SciDROM-scnm/LoRa_AQ/README.md

# LoRa_AQ
LoRa Air Quality station

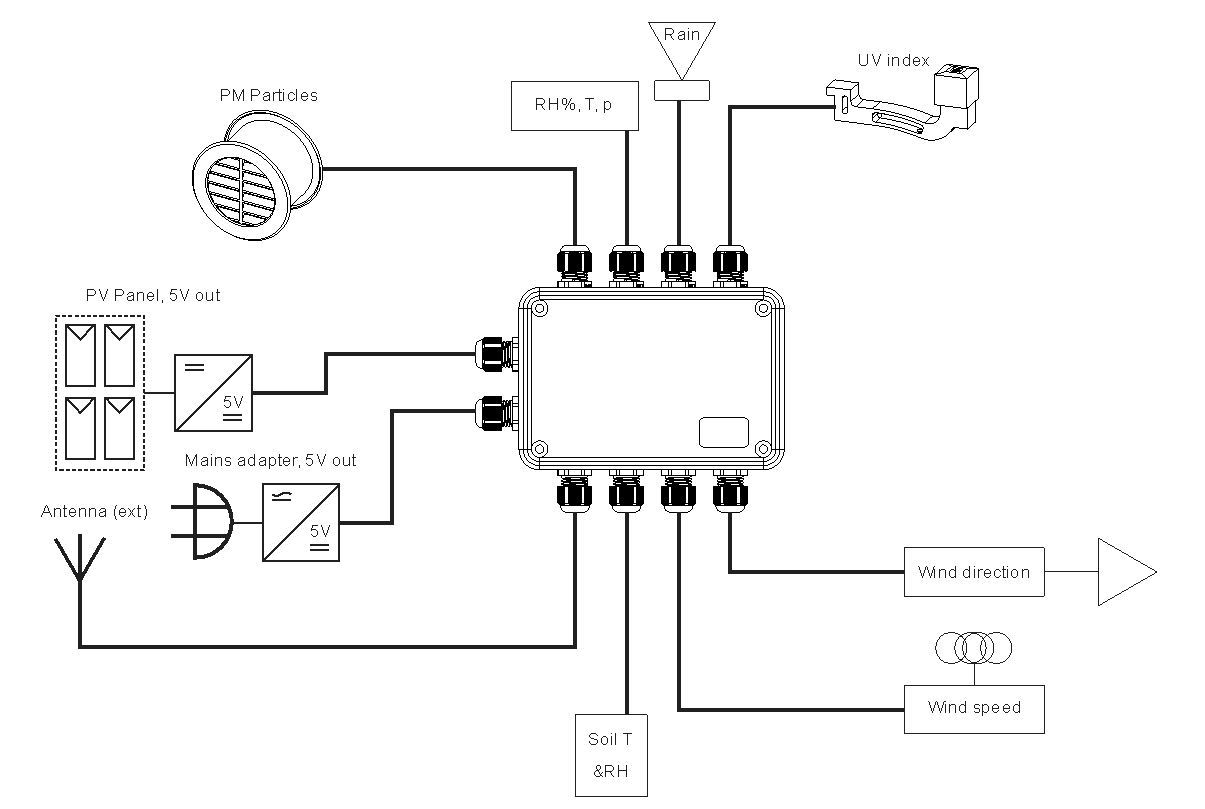
[picture p1: hw/block.jpg]
Block diagram
