SciDROM-scnm/LoRa_AQ/hw/photo/zlotano.jpg

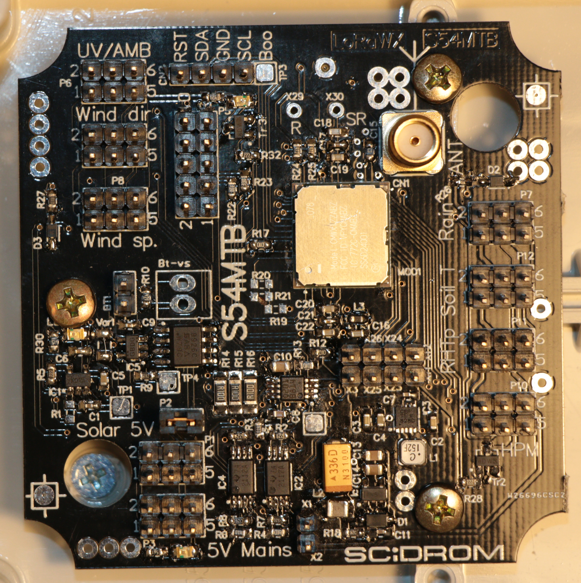
hw/photo/zlotano.jpg
