SciDROM-scnm/LoRa_AQ/hw/instructions/readme.md

## Instructions for assembling hardware

## Navodila za sestavljanje
