SciDROM-scnm/LoRa_AQ/hw/instructions/SLO/scidrom-PM - Priprava senzorja osvetlitve.pdf

LORA SENZORSKA POSTAJA ZA
SPREMLJANJE OKOLJA

## Šolski center Novo mesto SEŠTG 2018

## Mentor: Marko Pavlin

# PRIPRAVA

# SENZORJA OSVETLITVE

1

VSEBINA

2

SENZOR OSVETLITVE

Senzor osvetlitve je namenjen merjenju dnevne svetlobe in jakosti UV sevanja v spektru UVA in UVB.

Izgled sestavljenega senzorja:

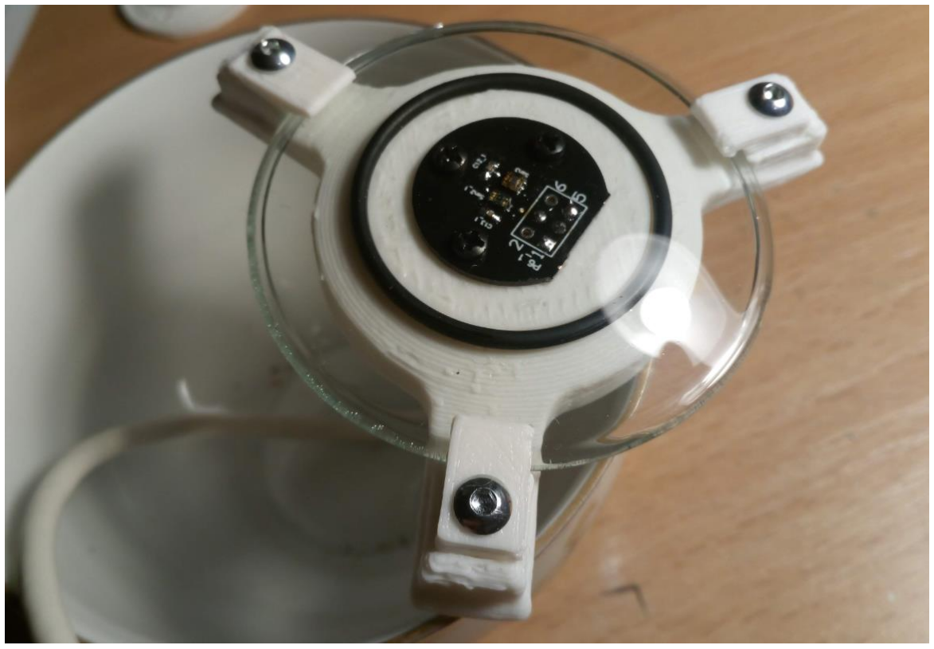
[picture p38: figure]

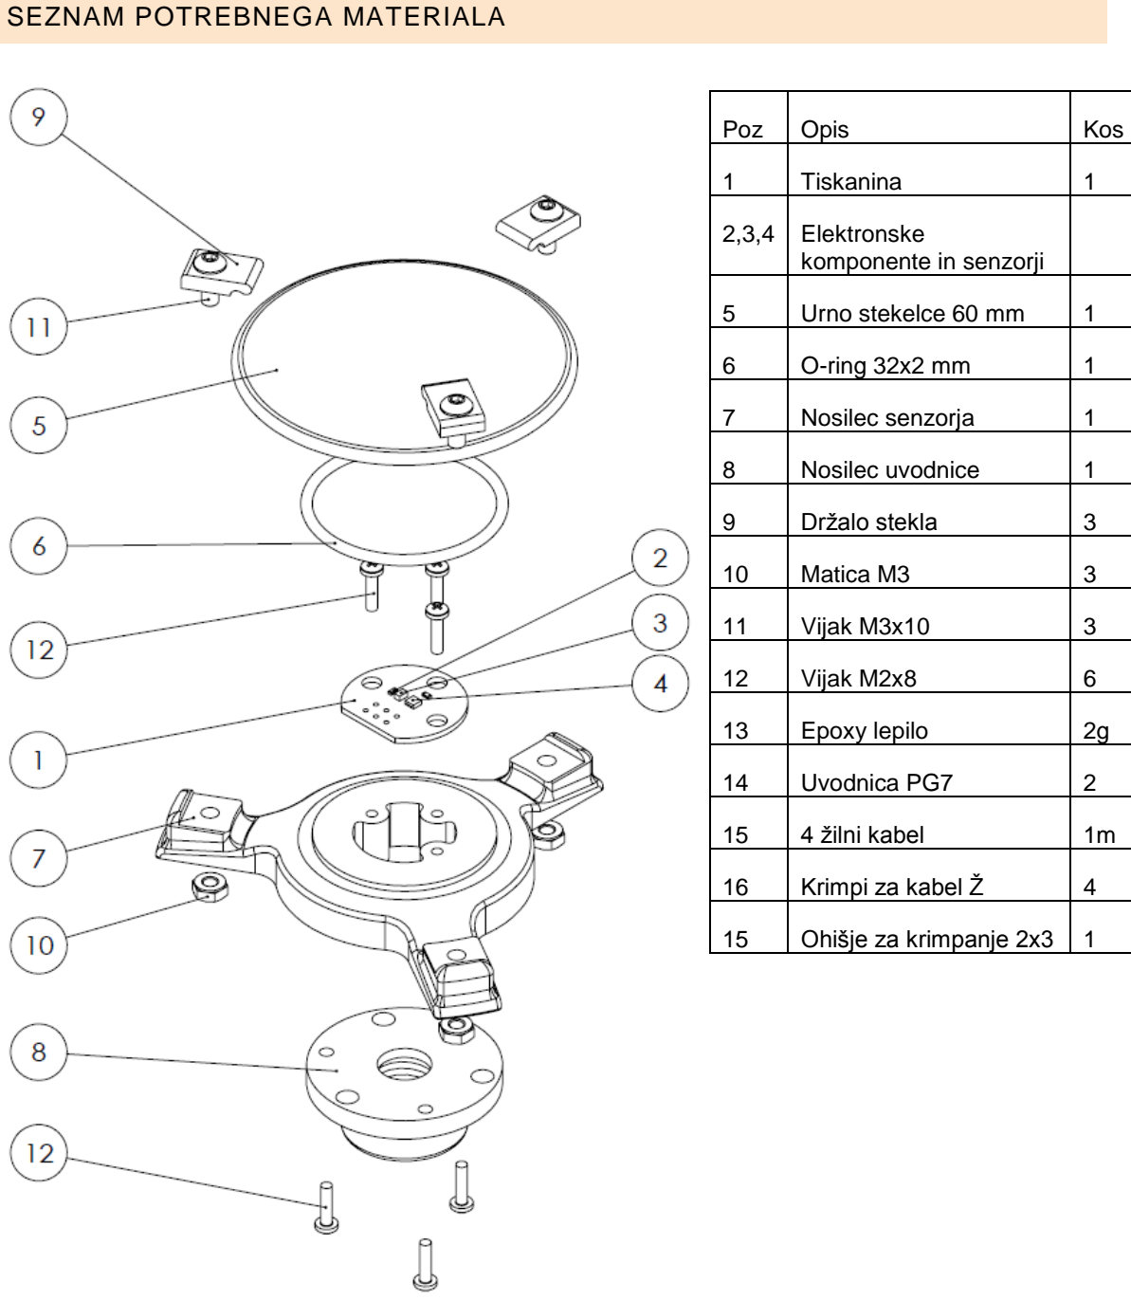
[picture p39: figure]
SEZNAM POTREBNEGA MATERIALA; Poz; Opis; Kos; Tiskanina; Elektronske komponente in senzorji; Urno stekelce 60 mm; O-ring 32x2 mm; Nosilec senzorja; Nosilec uvodnice; Držalo stekla; Matica M3; Vijak M3x10; Vijak M2x8; Epoxy lepilo; Uvodnica PG7; 4 žilni kabel; Krimpi za kabel Ž; Ohišje za krimpanje 2x3

3

4

POTREBNO ORODJE

Spajkalnik, ščipalke, klešče za snemanje izolacije, klešče za krimpanje kontaktov, šivalni stroj, škarje, pribor za mešanje epoxy lepila.

PRIPRAVA KABLA

Kablu na obeh koncih odstranimo oklop v razdalji pribl 25-30 mm in pripravimo notranje žile za spajkanje oz. krimpanje. Na strani senzorja prispajkamo žile kabla na tiskanino po naslednjem razporedu:

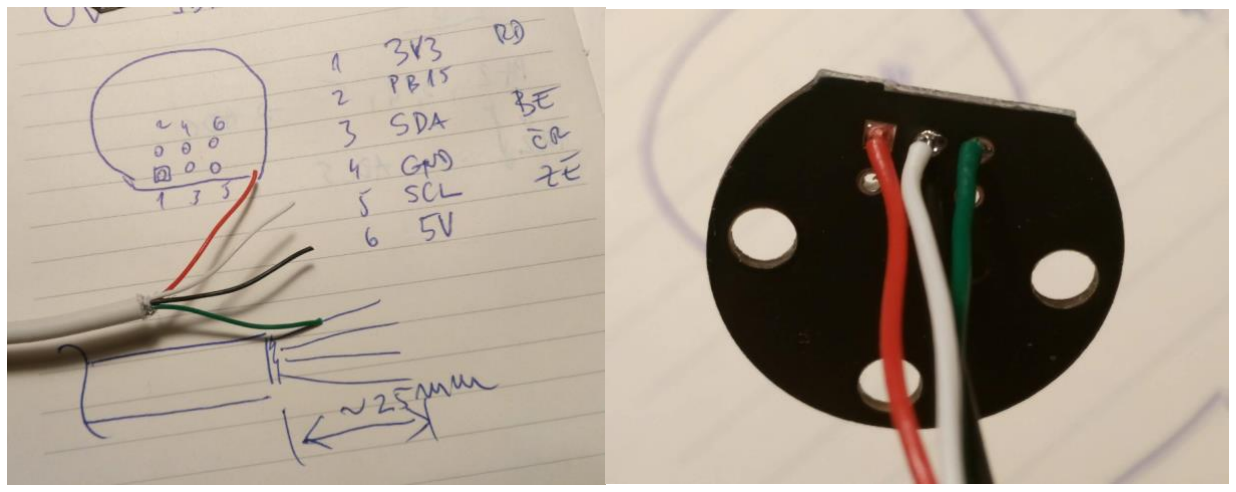
[picture p40: figure]

Shema konektorja:

Razpored:

Št. pina | Signal | Barva
1 | Napajanje 3,3V | Rdeča
2 | IRQ signal | Ni priključeno
3 | SDA | Bela
4 | GND | Črna
5 | SCL | Zelena
6 | +5V | Ni priključeno

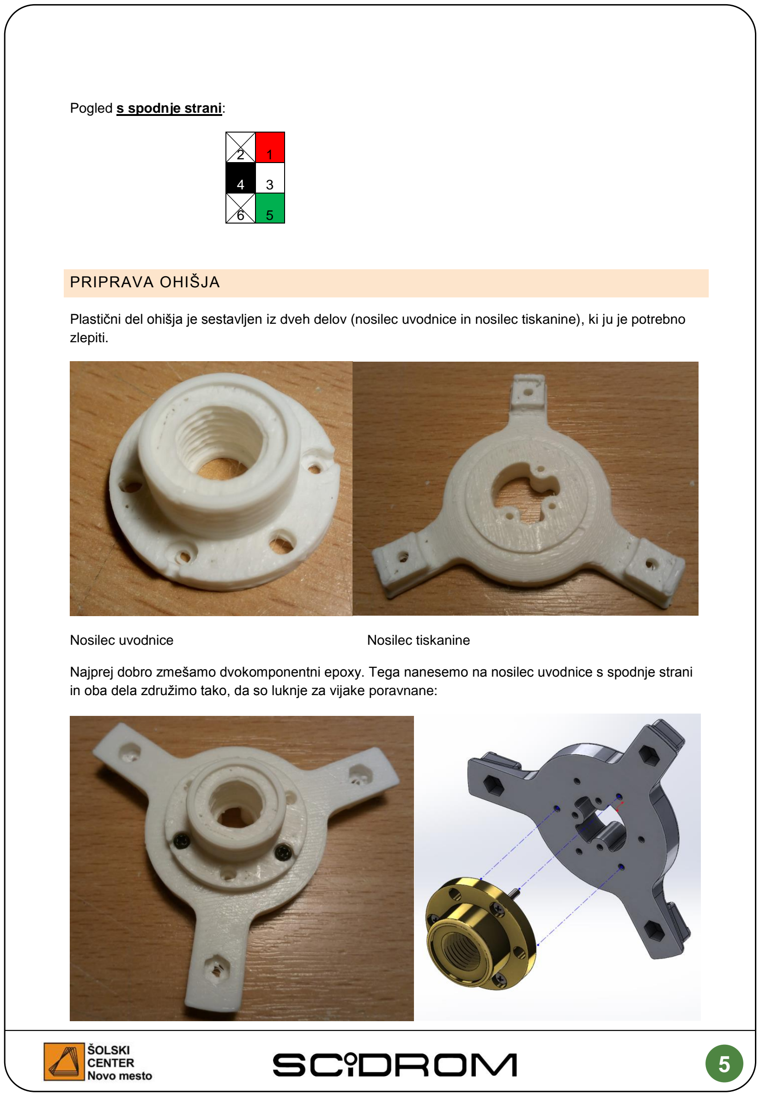
[picture p41: page 6]

5

Pogled s spodnje strani:

2 | 1
4 | 3
6 | 5

PRIPRAVA OHIŠJA

Plastični del ohišja je sestavljen iz dveh delov (nosilec uvodnice in nosilec tiskanine), ki ju je potrebno zlepiti.

Nosilec uvodnice | Nosilec tiskanine

Najprej dobro zmešamo dvokomponentni epoxy. Tega nanesemo na nosilec uvodnice s spodnje strani in oba dela združimo tako, da so luknje za vijake poravnane:

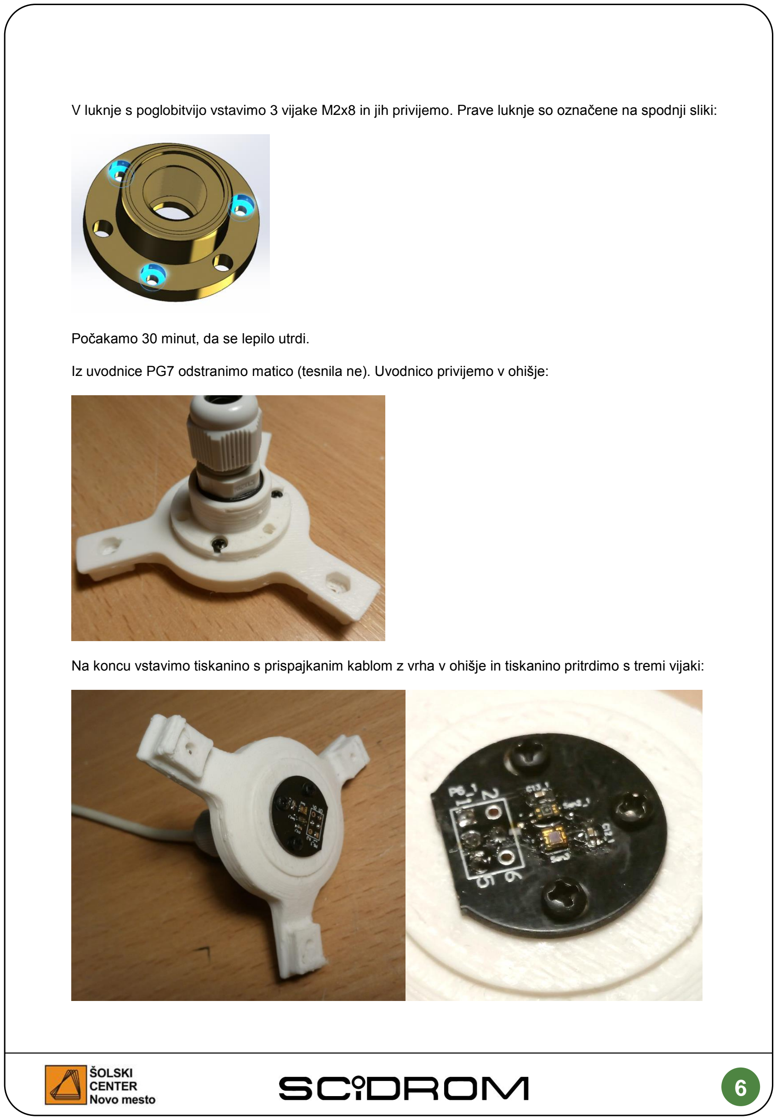
[picture p42: page 7]

6

V luknje s poglobitvijo vstavimo 3 vijake M2x8 in jih privijemo. Prave luknje so označene na spodnji sliki:

Počakamo 30 minut, da se lepilo utrdi.

Iz uvodnice PG7 odstranimo matico (tesnila ne). Uvodnico privijemo v ohišje:

Na koncu vstavimo tiskanino s prispajkanim kablom z vrha v ohišje in tiskanino pritrdimo s tremi vijaki:

7

Na krake ohišja s spodnje strani vstavimo tri matice M3:

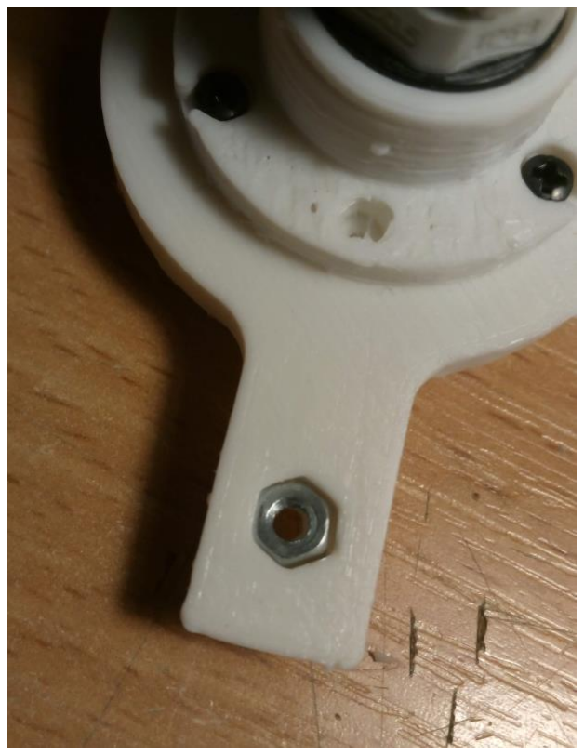
[picture p43: figure]

Na zgornjo stran ohišja postavimo O-ring:

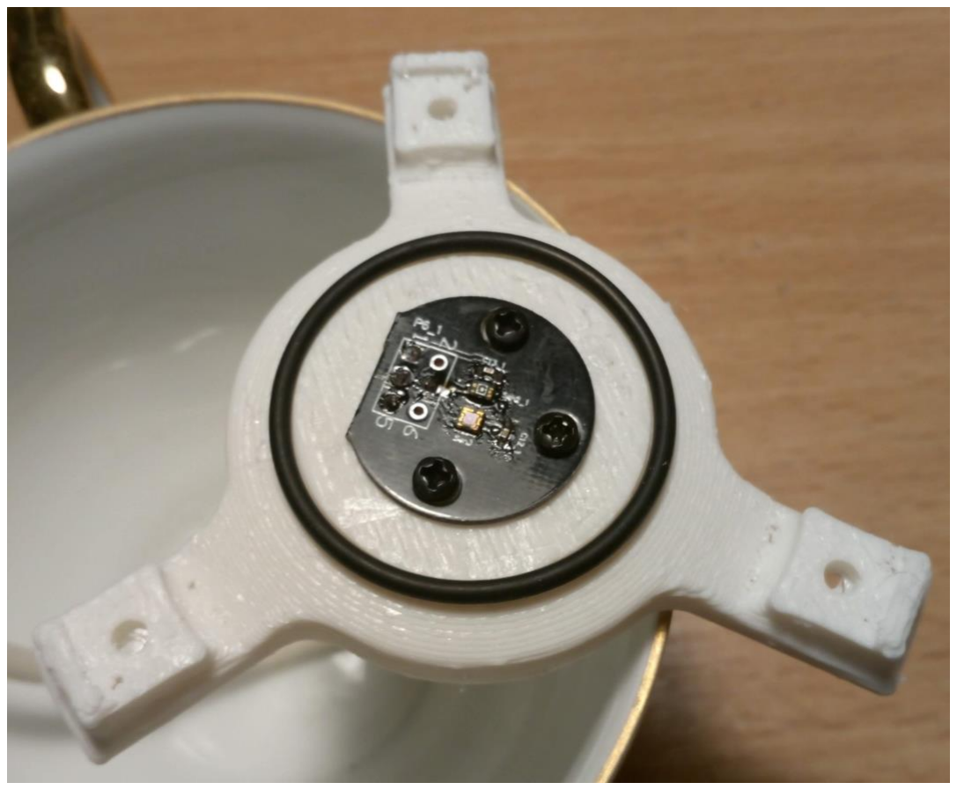
[picture p44: figure]

8

Očistimo urno stekelce, predvsem z notranje strani in ga postavimo na tesnilo:

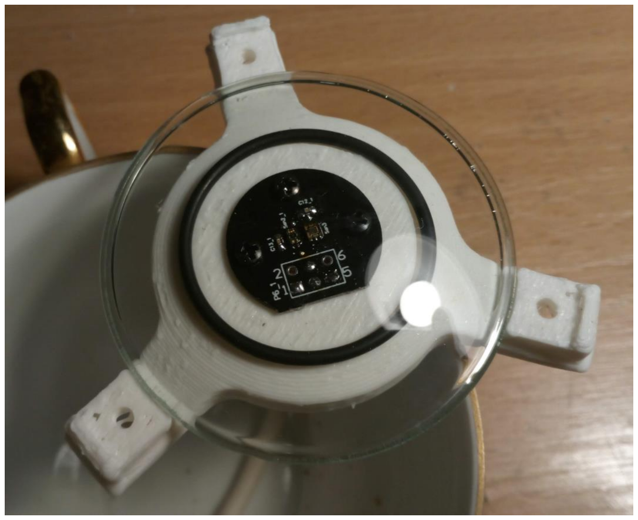
[picture p45: figure]

Steklo pritrdimo s tremi nosilci in privijemo s tremi vijaki M3x10:

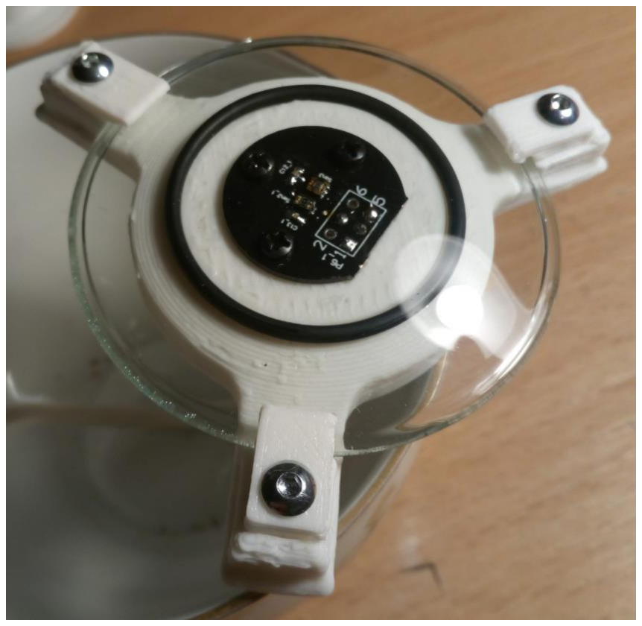
[picture p46: figure]
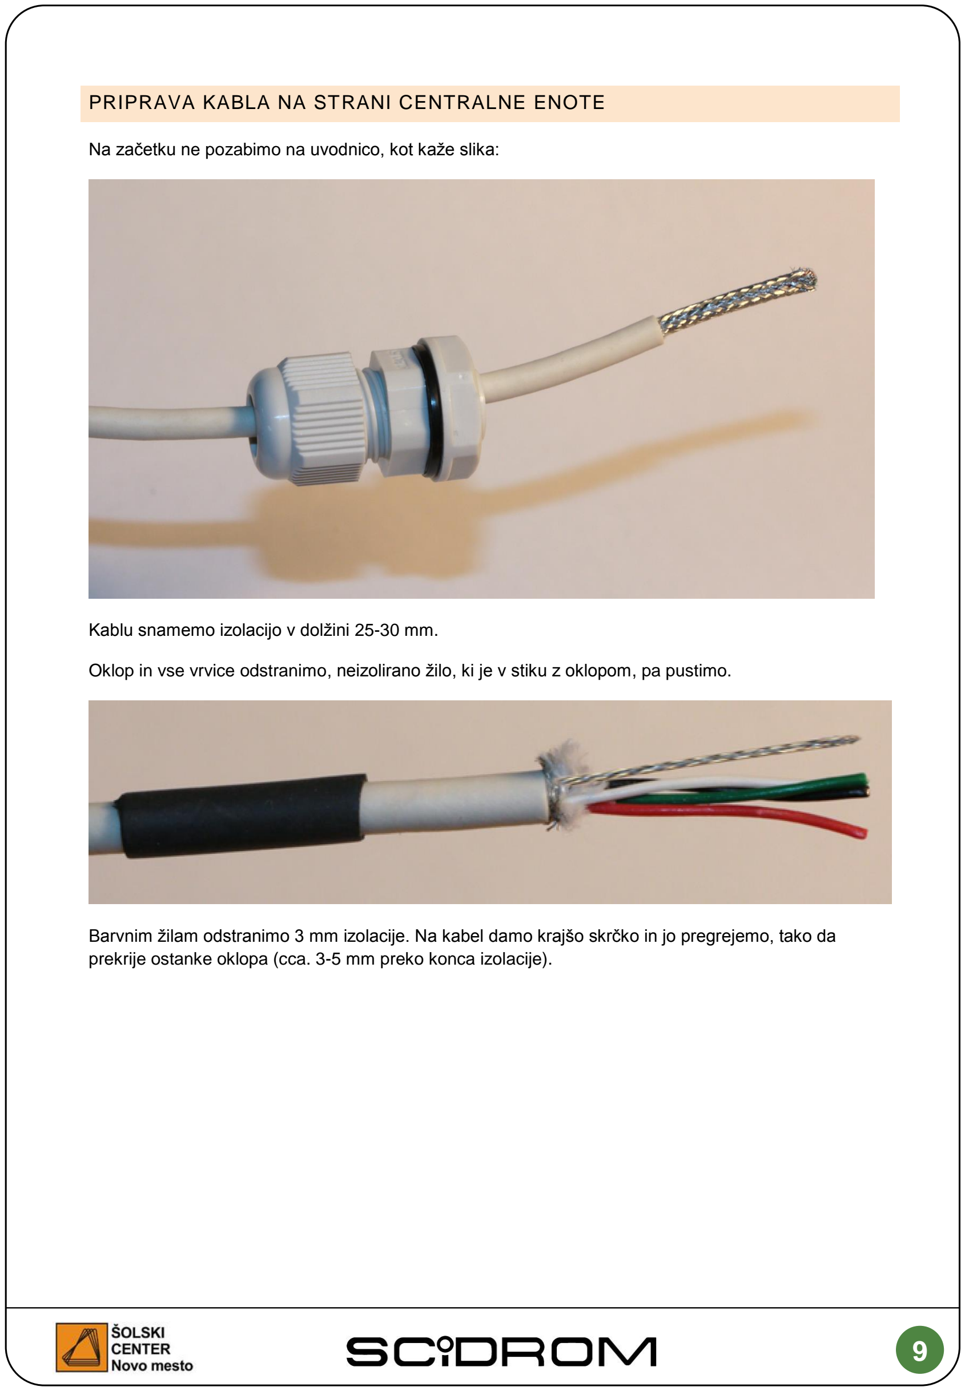
[picture p47: page 10]

9

PRIPRAVA KABLA NA STRANI CENTRALNE ENOTE

Na začetku ne pozabimo na uvodnico, kot kaže slika:

Kablu snamemo izolacijo v dolžini 25-30 mm.

Oklop in vse vrvice odstranimo, neizolirano žilo, ki je v stiku z oklopom, pa pustimo.

Barvnim žilam odstranimo 3 mm izolacije. Na kabel damo krajšo skrčko in jo pregrejemo, tako da prekrije ostanke oklopa (cca. 3-5 mm preko konca izolacije).

10

Neizolirano žico povijemo okrog črne.

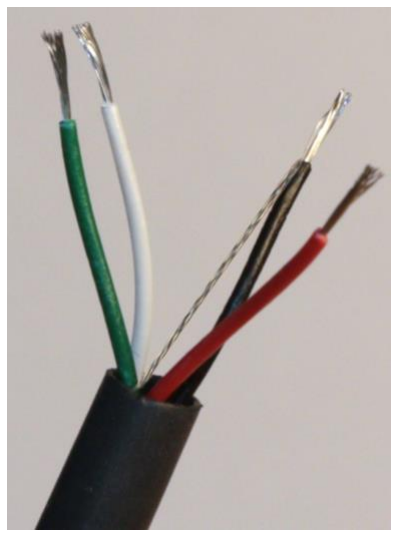
[picture p48: figure]

Pripravimo 4 JST kontakte za krimpanje.

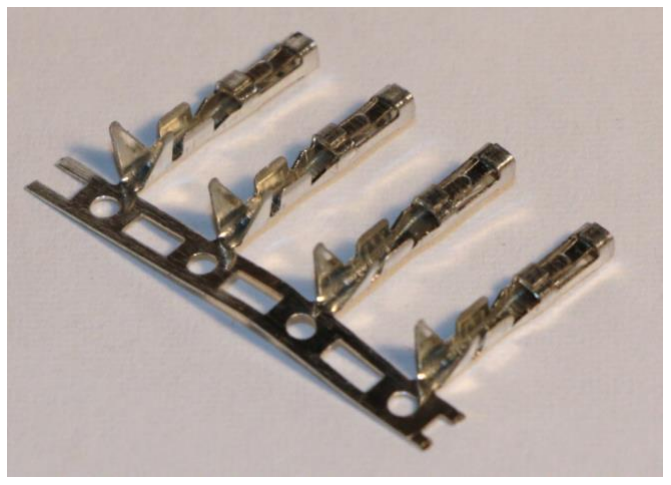
[picture p49: figure]

Za krimpanje potrebujemo klešče PA09 ali podobne.

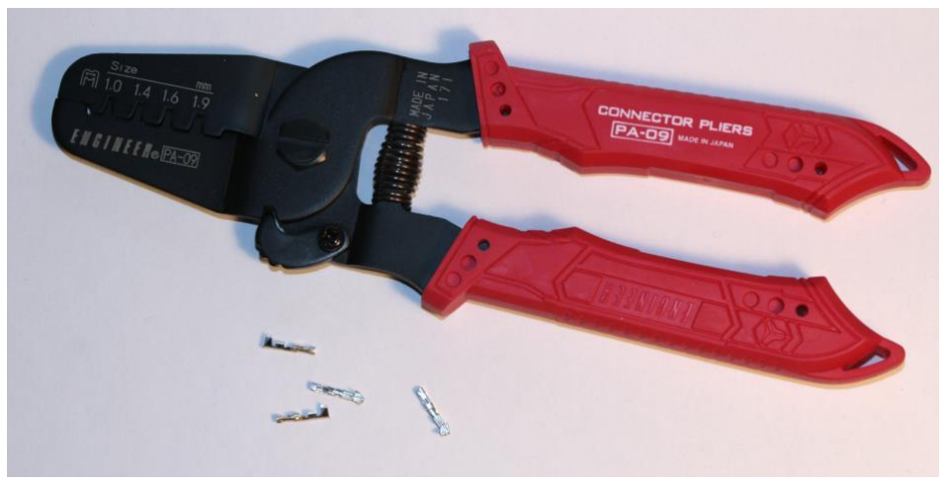
[picture p50: figure]

S takimi kleščami se krimpa v dveh potezah. Najprej del, ki objame neizoliran konec žice, sledi še drugi del, ki objame izolacijo. To ponovimo na vseh štirih žicah. Na spodnji fotografiji je na črni žici končano krimpanje, na beli pa le prvi korak:

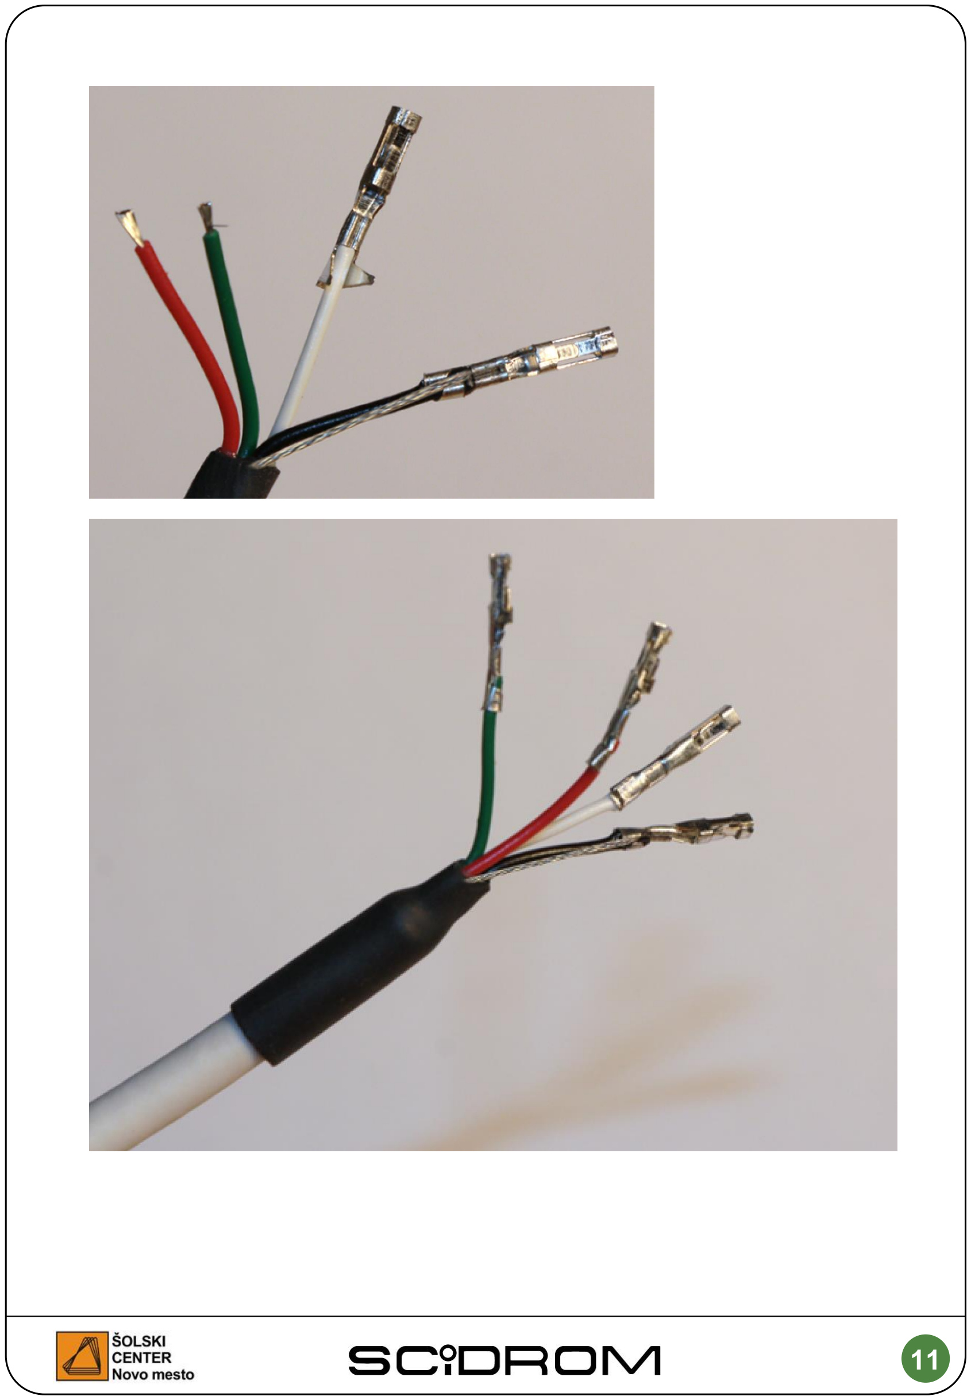
[picture p51: page 12]

11

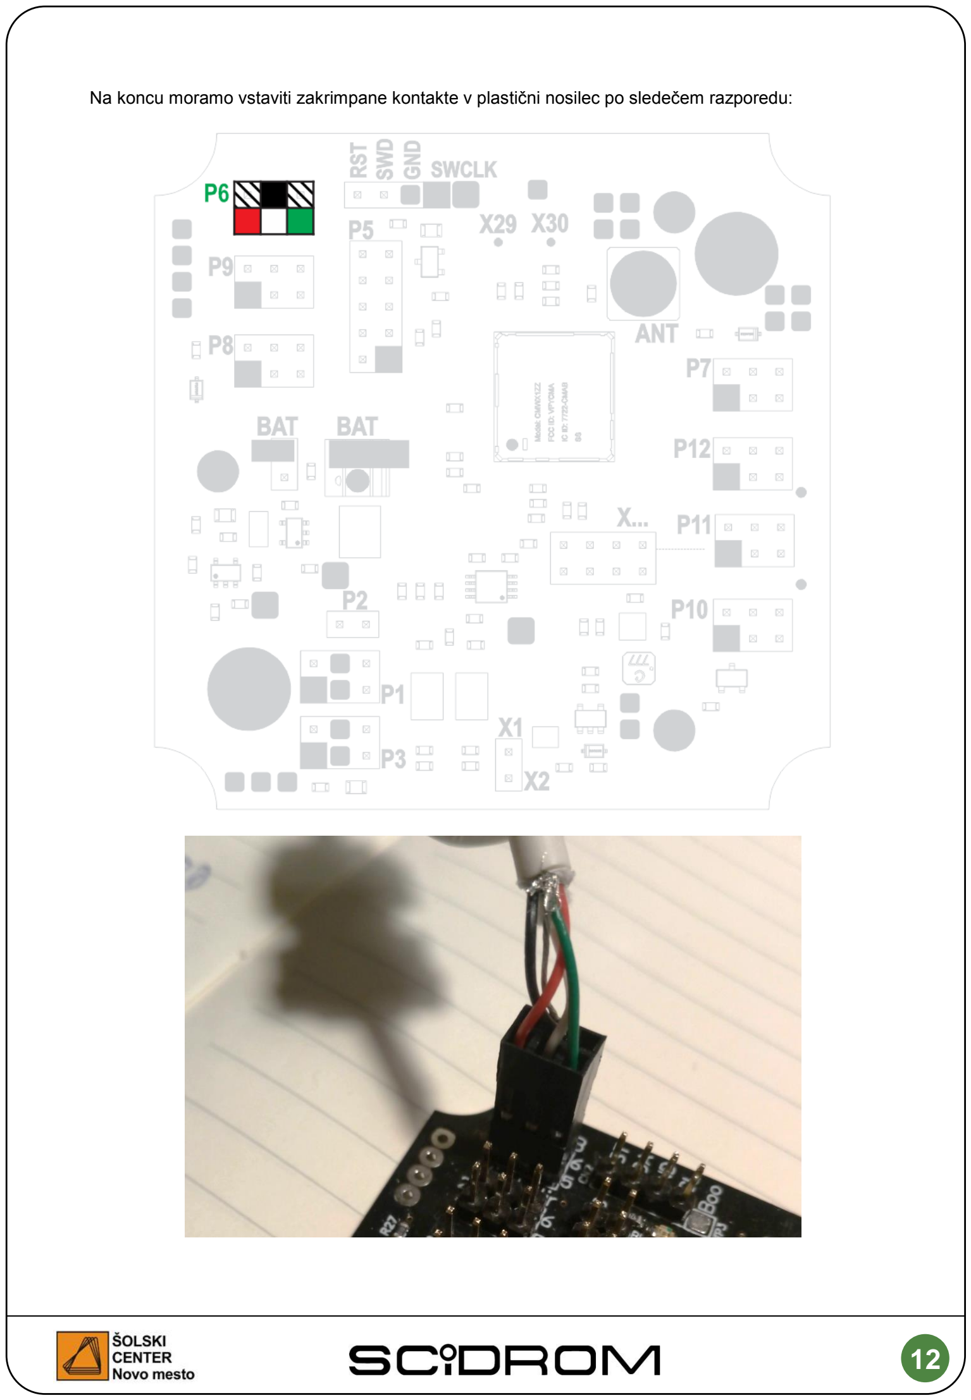
[picture p52: page 13]

12

Na koncu moramo vstaviti zakrimpane kontakte v plastični nosilec po sledečem razporedu:

13

Zapiski
