SciDROM-scnm/LoRa_AQ/hw/instructions/SLO/scidrom-PM - Priprava zascitnega ohisja za senzorje.pdf

LORA SENZORSKA POSTAJA ZA
SPREMLJANJE OKOLJA

## Šolski center Novo mesto SEŠTG 2018

## Mentor: Marko Pavlin

# PRIPRAVA ZAŠČITE ZA OKOLJSKE SENZORJE

1

VSEBINA

2

ZAŠČITNI ZASTOR ZA SENZORJE

Plastični zastor služi zaščiti senzorjev za vlago, temperaturo in tlak pred vplivom direktnih sončnih žarkov. Senzorji se nahajajo v notranjsti zastora, ki daje senco, obenem pa preko rež na obodu kroži zrak in omogoča zaznavanje stanja atmosfere. Celoten sestav je narejen iz plastičnih podstavkov, ki se uporabljajo za cvetlične lončke.

PRIPRAVA CVETLIČNIH PODSTAVKOV

Cvetlične postavke premera 120mm je potrebno izrezati po načrtu:

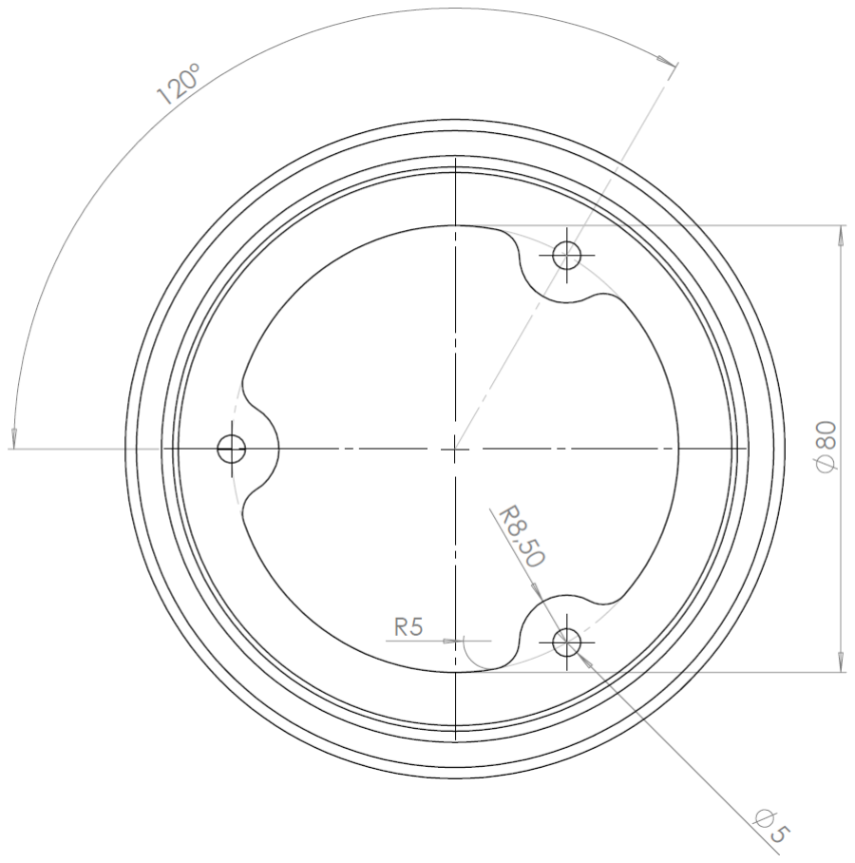
[picture p61: figure]
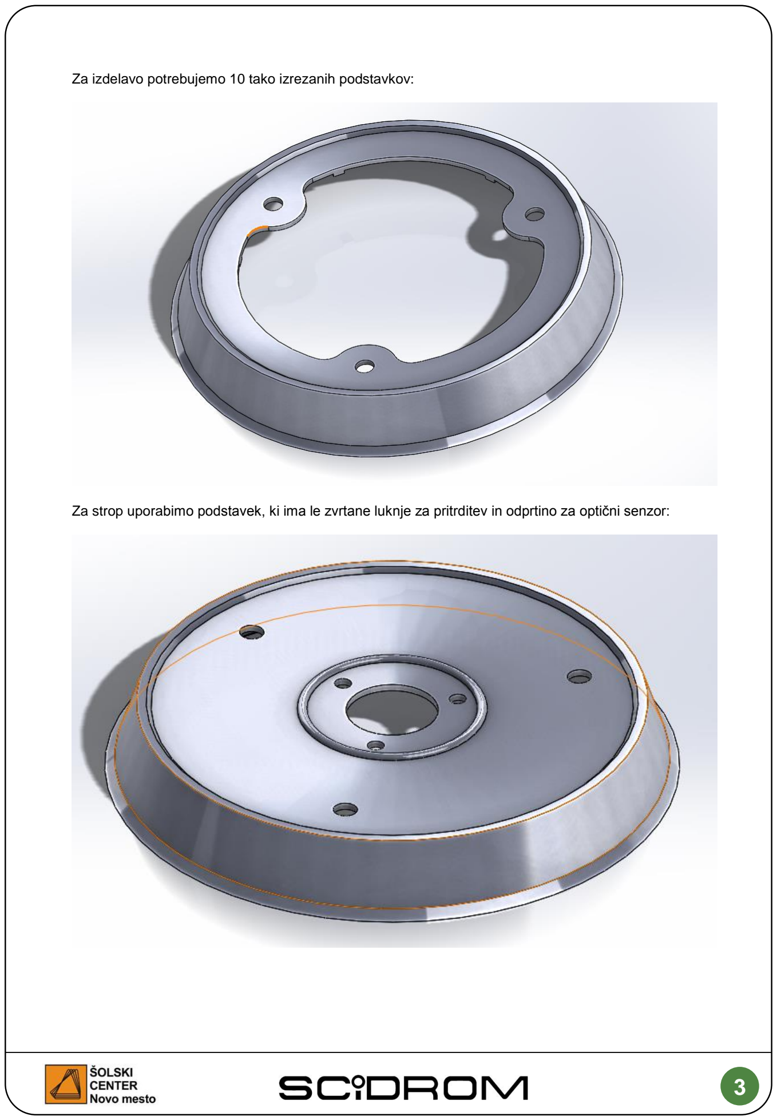
[picture p62: page 4]

3

Za izdelavo potrebujemo 10 tako izrezanih podstavkov:

Za strop uporabimo podstavek, ki ima le zvrtane luknje za pritrditev in odprtino za optični senzor:

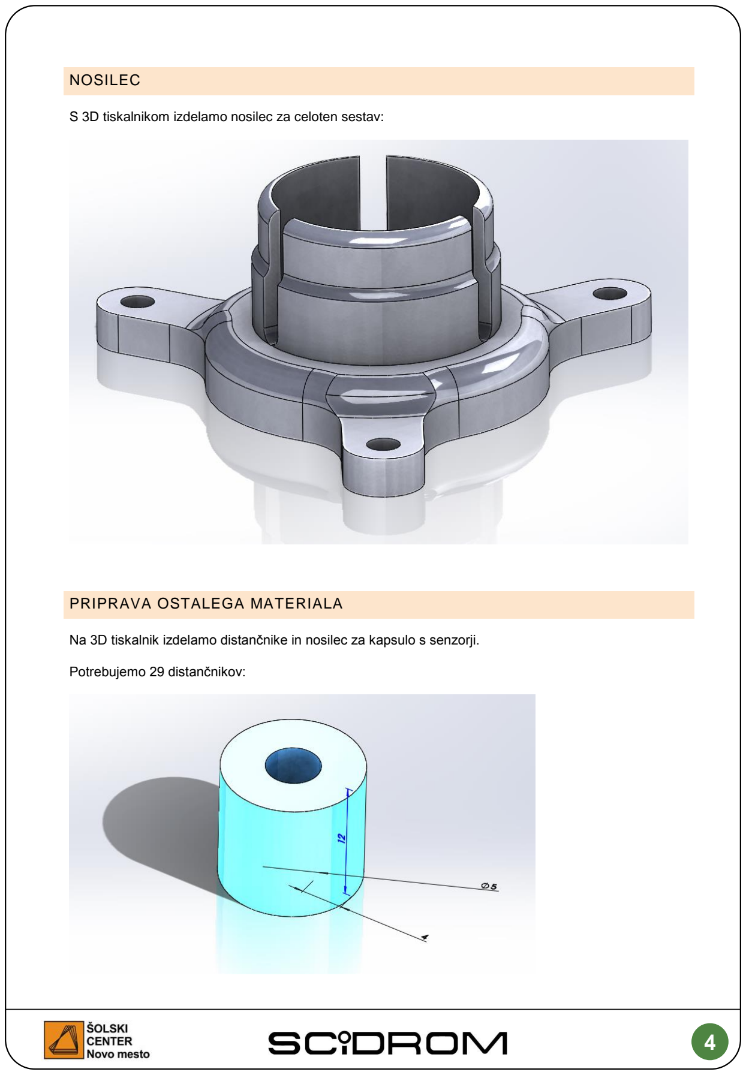
[picture p63: page 5]

4

NOSILEC

S 3D tiskalnikom izdelamo nosilec za celoten sestav:

PRIPRAVA OSTALEGA MATERIALA

Na 3D tiskalnik izdelamo distančnike in nosilec za kapsulo s senzorji.

Potrebujemo 29 distančnikov:

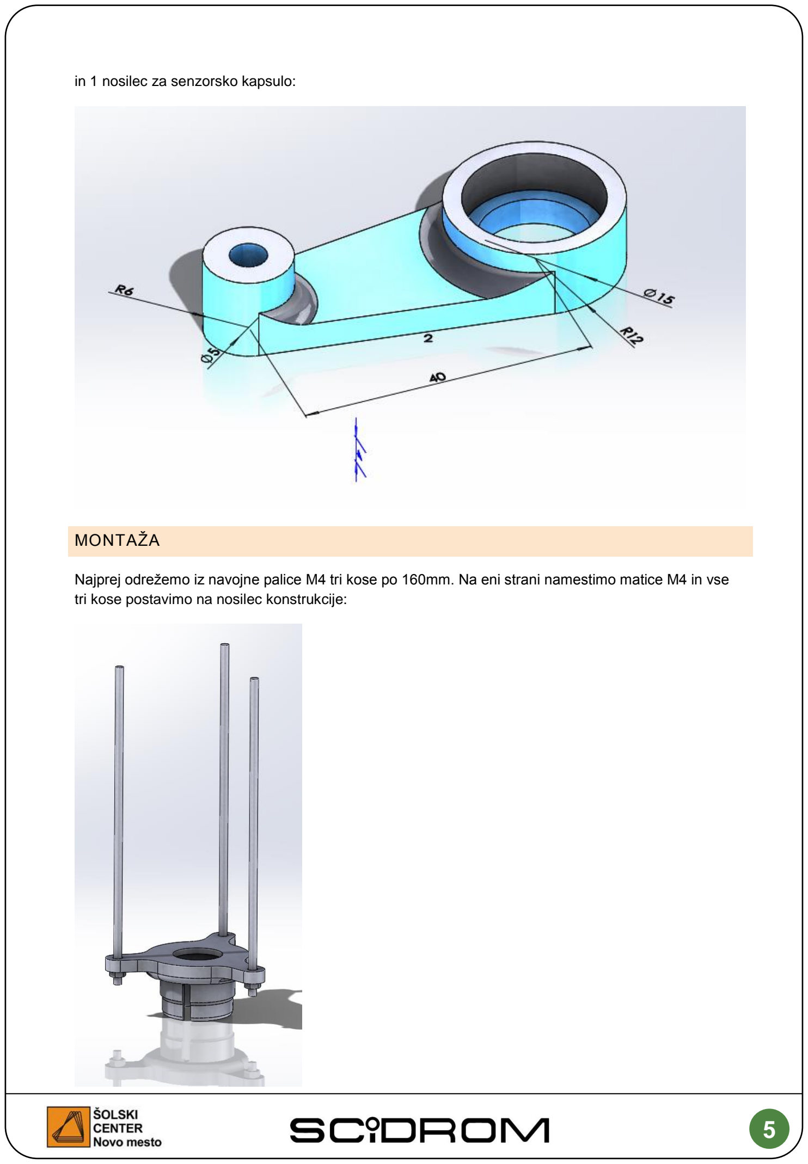
[picture p64: page 6]

5

in 1 nosilec za senzorsko kapsulo:

MONTAŽA

Najprej odrežemo iz navojne palice M4 tri kose po 160mm. Na eni strani namestimo matice M4 in vse tri kose postavimo na nosilec konstrukcije:

6

Pričnemo z zlaganjem podstavkov in distančnikov. V »7. nadstropju« namesto enega distančnika namestimo nosilec senzorske kapsule:

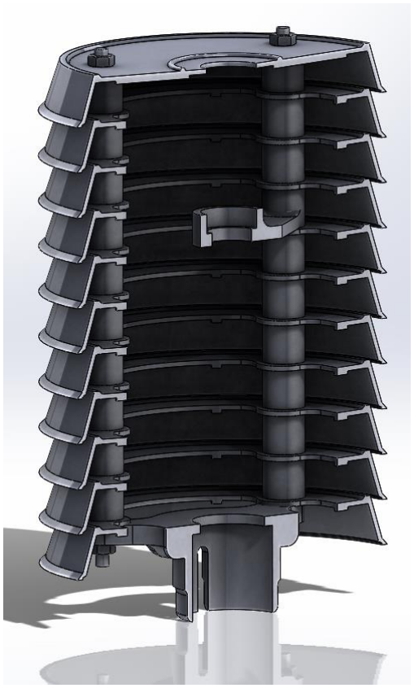
[picture p65: figure]

Na koncu dodamo zadnji pokrov za »streho«, privijemo še 3 matice, da se celotna struktura dobro stisne in učvrsti. S tem je senčnik pripravljen za montažo v sistem.

7

Zapiski
