SciDROM-scnm/LoRa_AQ/hw/sch/LoRaWX-sch.pdf

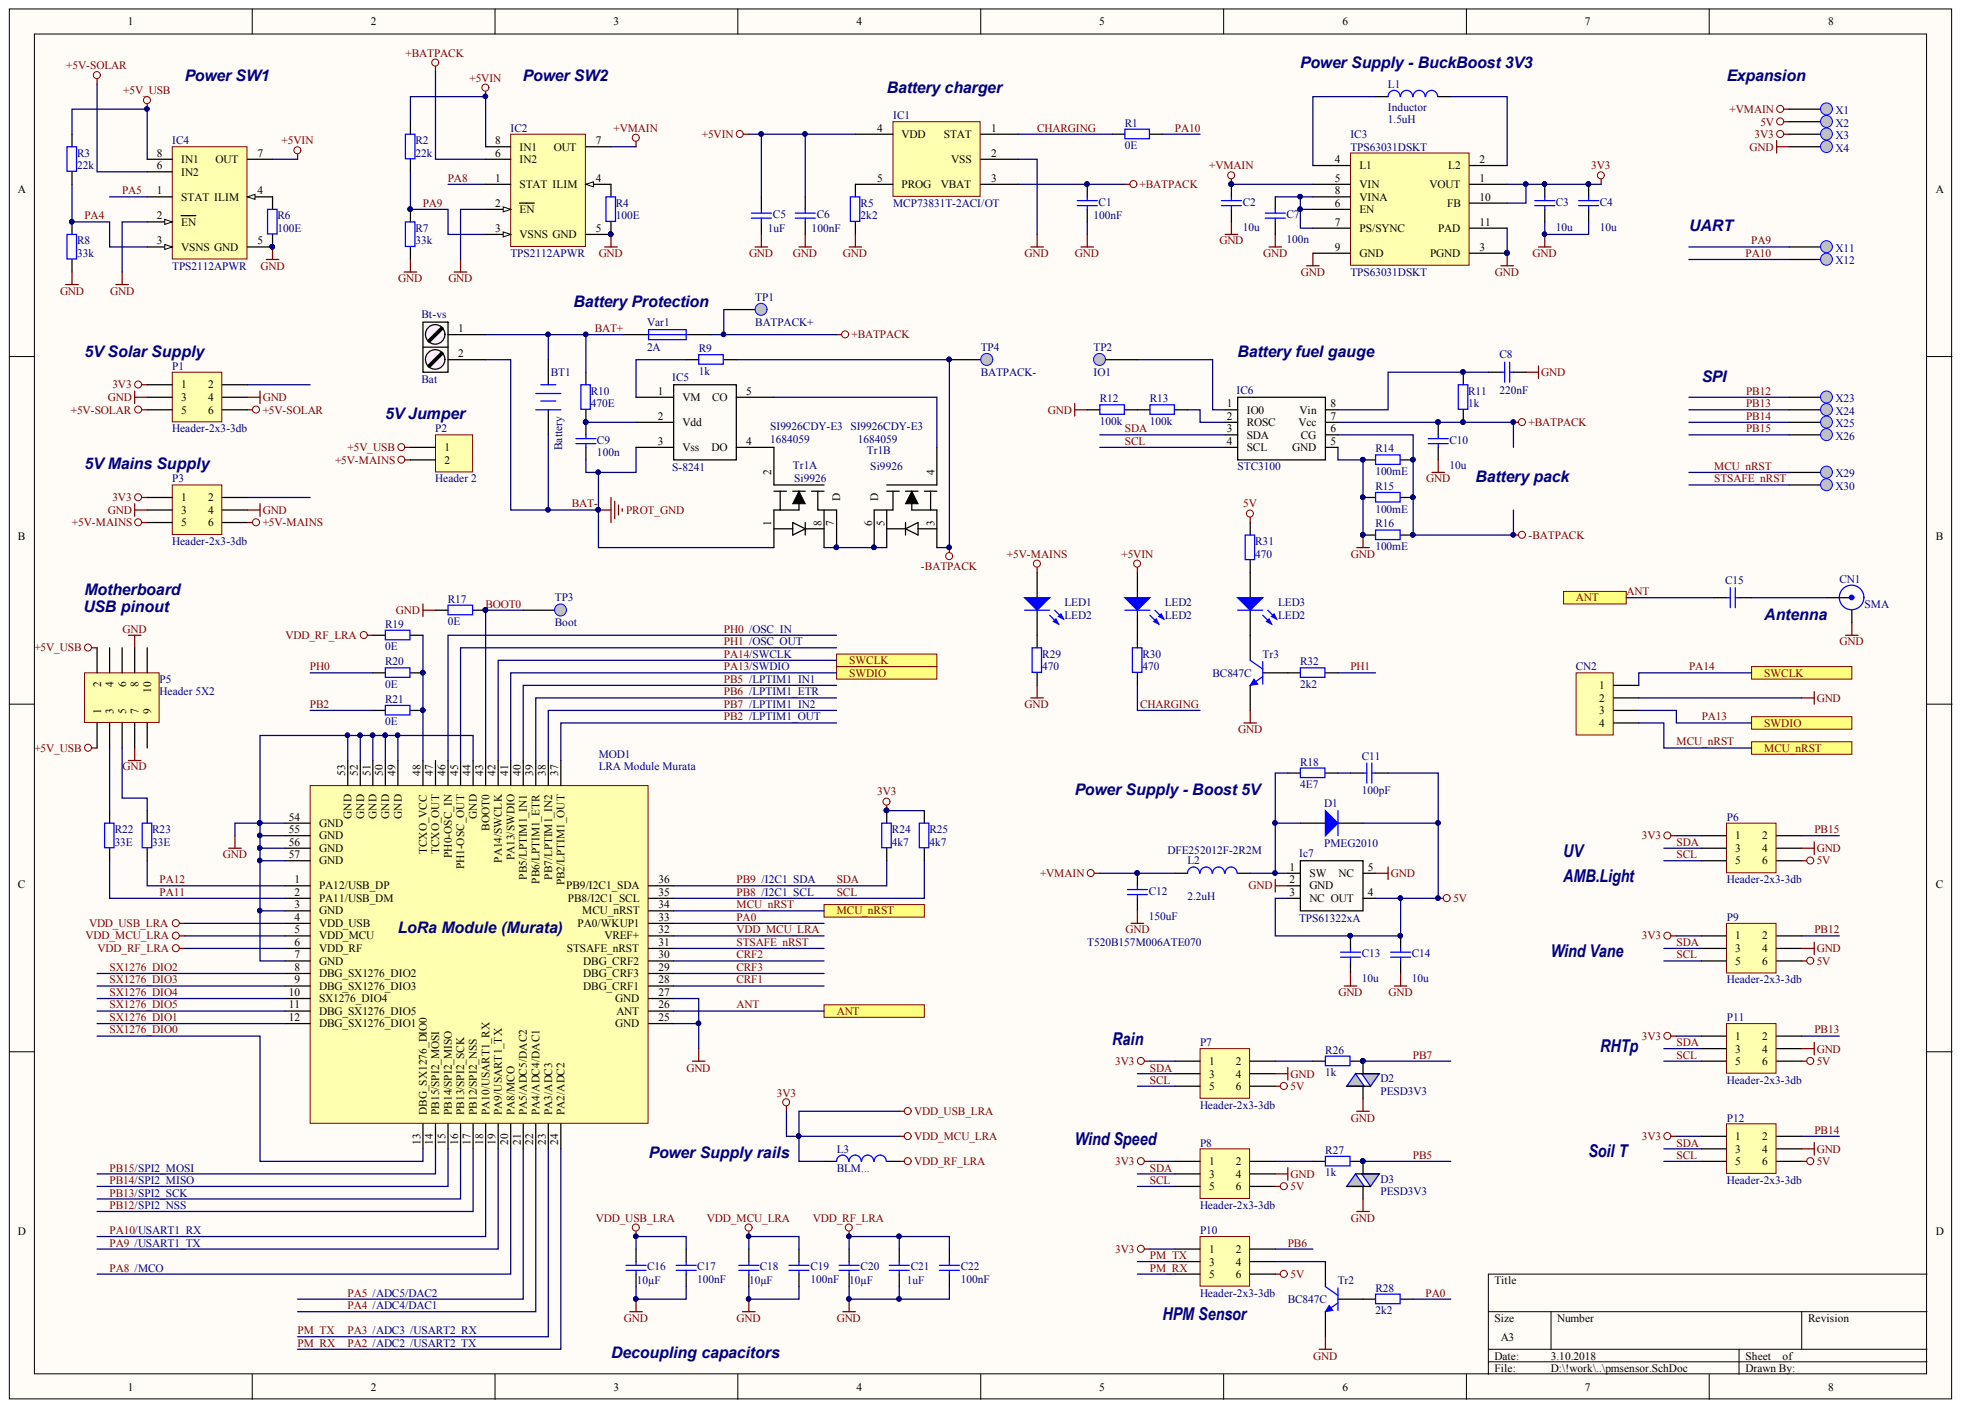
[picture p66: page 1]

PH1 /OSC_OUT
PA14 /SWCLK

GND 50 GND 51 GND 52 GND 53

GND 3 | MCU_nRST | MCU_nRST

DBG_SX1276_DIO1 12 | ANT
