SciDROM-scnm/LoRa_AQ/hw/sch/magnetic.pdf

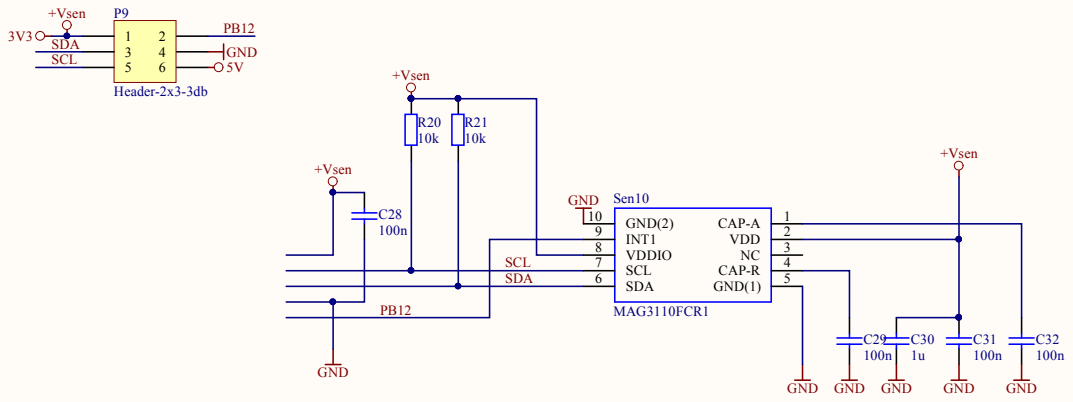
[picture p67: page 1]

SCL | 7 | | 4
SD A | 6 | | 5
