SciDROM-scnm/LoRa_AQ/hw/sch/rhtp-lorawx.pdf

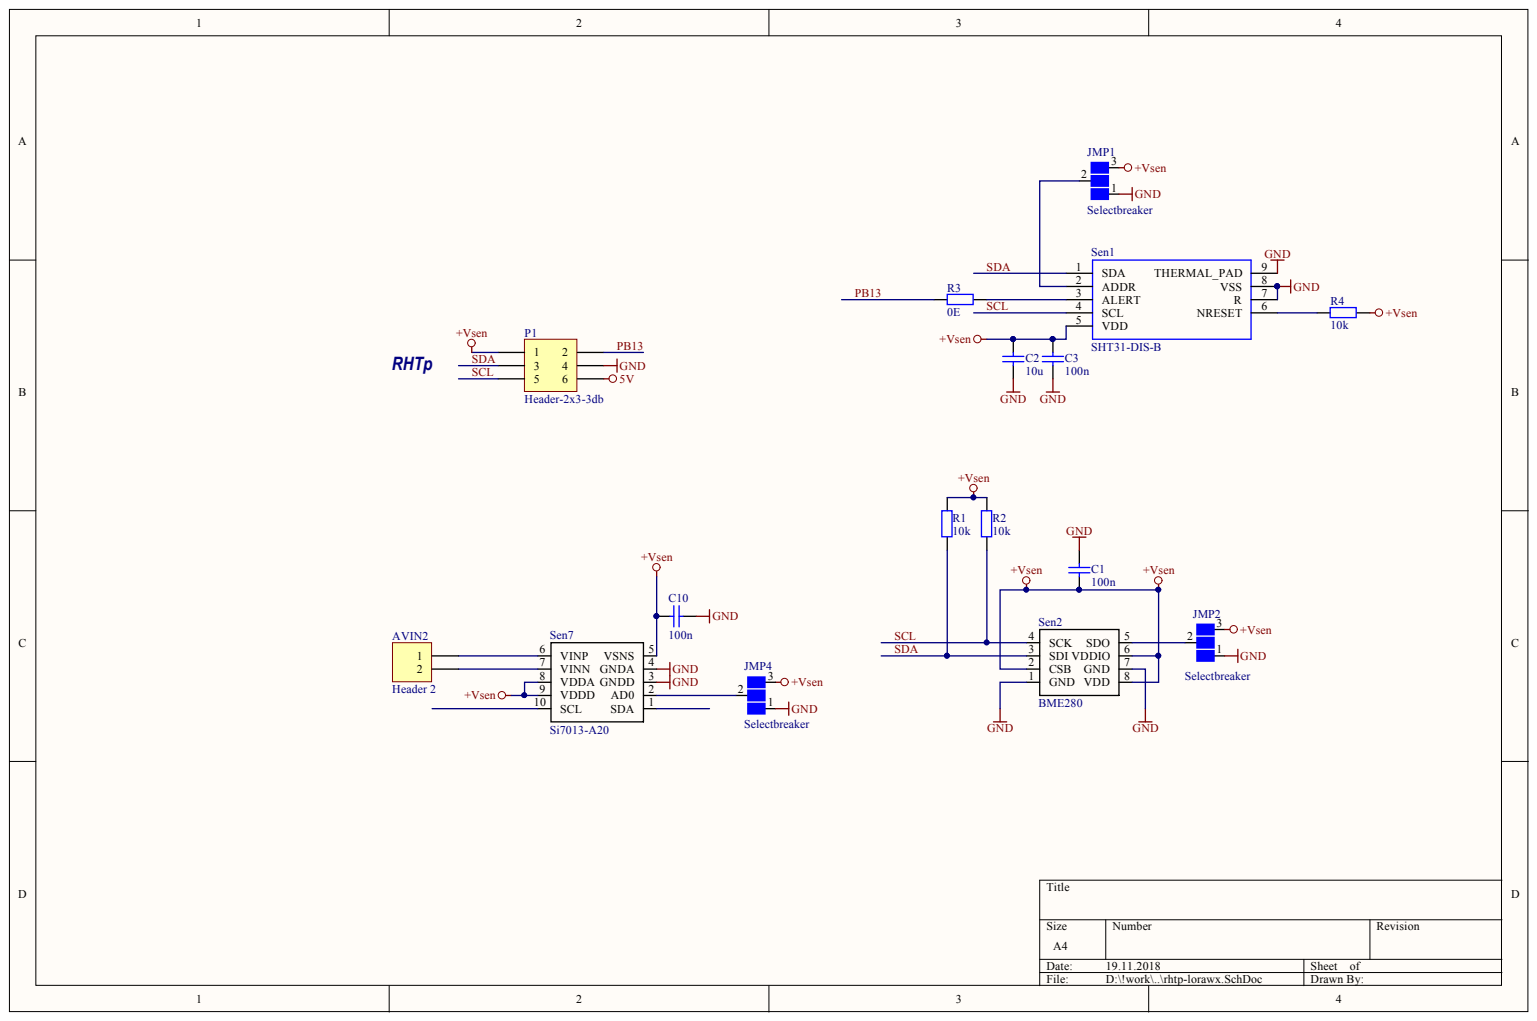
[picture p68: page 1]
