SciDROM-scnm/LoRa_AQ/hw/sch/uv-idx.pdf

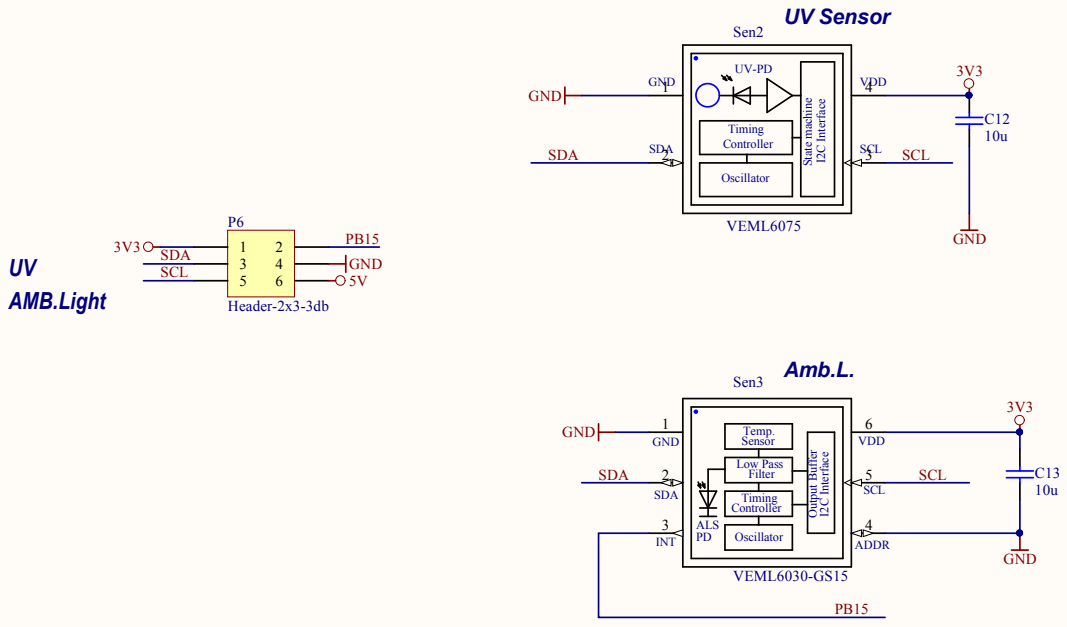
[picture p69: page 1]
