SciDROM-scnm/LoRa_AQ/sw/sensors/loradunchy_adc.c

 /***
 *      ____    ____  _  ____   ____    ___   __  __ 
 *     / ___|  / ___|(_)|  _ \ |  _ \  / _ \ |  \/  |
 *     \___ \ | |    | || | | || |_) || | | || |\/| |
 *      ___) || |___ | || |_| ||  _ < | |_| || |  | |
 *     |____/  \____||_||____/ |_| \_\ \___/ |_|  |_|
 *        (C)2018 Scidrom 
 
	Description: ADC driver
	License: GNU General Public License
	Maintainer: S54MTB
*/

/******************************************************************************
  * @file    loradunchy_adc.c
  * @author  S54MTB
  * @version V1.0.0
  * @date    14-December-2018
  * @brief   adc driver
  ******************************************************************************
  * @attention
  *
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
  * You should have received a copy of the GNU General Public License
  * along with this program.  If not, see <https://www.gnu.org/licenses/>.  
  ******************************************************************************
  */

#include "loradunchy_adc.h"
// ADC readouts buffer
static uint16_t adcreadouts[4];


ADC_HandleTypeDef hadc;
DMA_HandleTypeDef hdma_adc;


uint16_t loradunchy_ADC_GetValue(uint8_t ch)
{
  return (adcreadouts[ch]);
}


void loradunchy_adc_start(void)
{
  HAL_ADC_Start_DMA(&hadc, (uint32_t *)adcreadouts, 4);
}


void loradunchy_adc_init(void)
{
  ADC_ChannelConfTypeDef sConfig = {0};

  __HAL_RCC_GPIOA_CLK_ENABLE();  
  /* DMA controller clock enable */
  __HAL_RCC_DMA1_CLK_ENABLE();

  /* DMA interrupt init */
  /* DMA1_Channel1_IRQn interrupt configuration */
  HAL_NVIC_SetPriority(DMA1_Channel1_IRQn, 0, 0);
  HAL_NVIC_EnableIRQ(DMA1_Channel1_IRQn);

  /**Configure the global features of the ADC (Clock, Resolution, Data Alignment and number of conversion) 
  */
  hadc.Instance = ADC1;
  hadc.Init.OversamplingMode = DISABLE;
  hadc.Init.ClockPrescaler = ADC_CLOCK_SYNC_PCLK_DIV1;
  hadc.Init.Resolution = ADC_RESOLUTION_12B;
  hadc.Init.SamplingTime = ADC_SAMPLETIME_1CYCLE_5;
  hadc.Init.ScanConvMode = ADC_SCAN_DIRECTION_FORWARD;
  hadc.Init.DataAlign = ADC_DATAALIGN_RIGHT;
  hadc.Init.ContinuousConvMode = ENABLE;
  hadc.Init.DiscontinuousConvMode = DISABLE;
  hadc.Init.ExternalTrigConvEdge = ADC_EXTERNALTRIGCONVEDGE_NONE;
  hadc.Init.ExternalTrigConv = ADC_SOFTWARE_START;
  hadc.Init.DMAContinuousRequests = DISABLE;
  hadc.Init.EOCSelection = ADC_EOC_SEQ_CONV;
  hadc.Init.Overrun = ADC_OVR_DATA_PRESERVED;
  hadc.Init.LowPowerAutoWait = DISABLE;
  hadc.Init.LowPowerFrequencyMode = DISABLE;
  hadc.Init.LowPowerAutoPowerOff = DISABLE;
  HAL_ADC_Init(&hadc);

  /**Configure for the selected ADC regular channels to be converted. 
  */
  sConfig.Channel = ADC_CHANNEL_2;
  sConfig.Rank = ADC_RANK_CHANNEL_NUMBER;
  HAL_ADC_ConfigChannel(&hadc, &sConfig);
  sConfig.Channel = ADC_CHANNEL_3;
  HAL_ADC_ConfigChannel(&hadc, &sConfig);
  sConfig.Channel = ADC_CHANNEL_4;
  HAL_ADC_ConfigChannel(&hadc, &sConfig);
  sConfig.Channel = ADC_CHANNEL_5;
  HAL_ADC_ConfigChannel(&hadc, &sConfig);
  
}


/** HAL MSP instances ------------------------------------------ */

/**
  * @brief This function handles DMA1 channel 1 interrupt.
  */
void DMA1_Channel1_IRQHandler(void)
{
  HAL_DMA_IRQHandler(&hdma_adc);
}



/**
* @brief ADC MSP Initialization
* This function configures the hardware resources used for this project
* @param hadc: ADC handle pointer
* @retval None
*/
void HAL_ADC_MspInit(ADC_HandleTypeDef* hadc)
{

  GPIO_InitTypeDef GPIO_InitStruct = {0};
  if(hadc->Instance==ADC1)
  {
    /* Peripheral clock enable */
    __HAL_RCC_ADC1_CLK_ENABLE();
  
    __HAL_RCC_GPIOA_CLK_ENABLE();
    /**ADC GPIO Configuration    
    PA4     ------> ADC_IN4
    PA2     ------> ADC_IN2
    PA5     ------> ADC_IN5
    PA3     ------> ADC_IN3 
    */
    GPIO_InitStruct.Pin = GPIO_PIN_4|GPIO_PIN_2|GPIO_PIN_5|GPIO_PIN_3;
    GPIO_InitStruct.Mode = GPIO_MODE_ANALOG;
    GPIO_InitStruct.Pull = GPIO_NOPULL;
    HAL_GPIO_Init(GPIOA, &GPIO_InitStruct);

    /* ADC1 DMA Init */
    /* ADC Init */
    hdma_adc.Instance = DMA1_Channel1;
    hdma_adc.Init.Request = DMA_REQUEST_0;
    hdma_adc.Init.Direction = DMA_PERIPH_TO_MEMORY;
    hdma_adc.Init.PeriphInc = DMA_PINC_DISABLE;
    hdma_adc.Init.MemInc = DMA_MINC_ENABLE;
    hdma_adc.Init.PeriphDataAlignment = DMA_PDATAALIGN_HALFWORD;
    hdma_adc.Init.MemDataAlignment = DMA_MDATAALIGN_HALFWORD;
    hdma_adc.Init.Mode = DMA_CIRCULAR;
    hdma_adc.Init.Priority = DMA_PRIORITY_LOW;
    HAL_DMA_Init(&hdma_adc);

    __HAL_LINKDMA(hadc,DMA_Handle,hdma_adc);

  }

}

/**
* @brief ADC MSP De-Initialization
* This function freeze the hardware resources used in this example
* @param hadc: ADC handle pointer
* @retval None
*/

void HAL_ADC_MspDeInit(ADC_HandleTypeDef* hadc)
{

  if(hadc->Instance==ADC1)
  {
    /* Peripheral clock disable */
    __HAL_RCC_ADC1_CLK_DISABLE();
  
    /**ADC GPIO Configuration    
    PA4     ------> ADC_IN4
    PA2     ------> ADC_IN2
    PA5     ------> ADC_IN5
    PA3     ------> ADC_IN3 
    */
    HAL_GPIO_DeInit(GPIOA, GPIO_PIN_4|GPIO_PIN_2|GPIO_PIN_5|GPIO_PIN_3);

    /* ADC1 DMA DeInit */
    HAL_DMA_DeInit(hadc->DMA_Handle);
  }

}
